purduerov/X11-Solenoid-Board/notes.txt

Fix airwires
Min trace width of 10 for signals, 30 for power
Leave pads straight out instead of skewed
Keep a trace width between traces
Add a GND polygon to the bottom side
Via stitch the GND planes
Mounting holes/standoffs, make sure they are aligned and sane. You might only fit 3, thats ok
SW, 12V, 24V, related should be width 30
Do not route anything through the region near an oscillator
Swap CAN_H, CAN_L with +12V, GND on the input T2I connector, move the CAN transceiver down instead
Bulk cap goes up top

Grant's Notes:
GND airwires due to isolate, min width, and ground stitching. Fixed
Still angled traced on decoupling caps below micro. Left some as is 
2 small GND polygons not filling in. 
+3.3V instead of +3V3. Fixed. Is it ok to run the shift register's power through the same trace as the micro?
redid +12V around the inductor. +12 now splits 1) to inductor and 2) to cap  and through to IC and SHDN trace
Should there be ground plane beneath the inductor?
