purduerov/X11-Solenoid-Board/Solenoid Boardv2.brd

## EAGLE design Solenoid Boardv2.brd (2019-03-25)

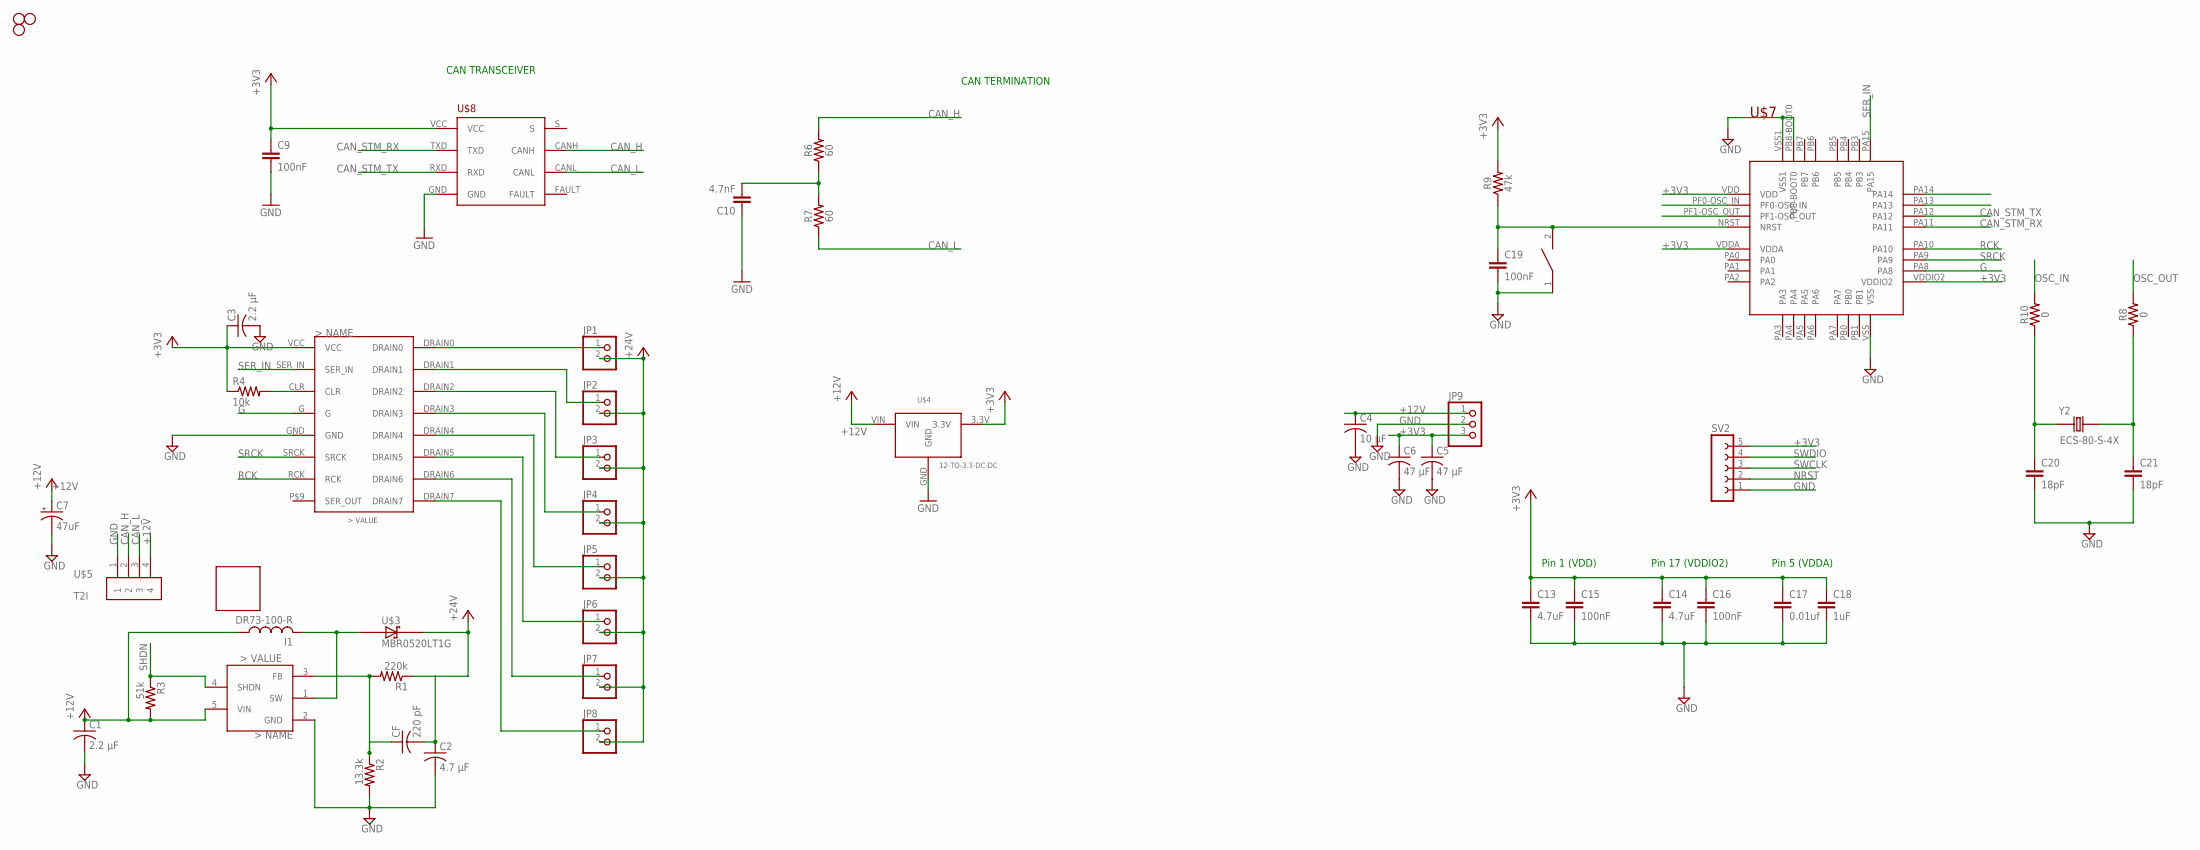
[picture p1: schematic Solenoid Boardv2.sch]

Parts:
C1, C3: 2.2 µF; C0805
C2: 4.7 µF; C0805
C4: 10 µF; C0805
C5, C6: 47 µF; C0805
C7: 47uF; PANASONIC_D
C9, C15, C16, C19: 100nF; 0603
C10: 4.7nF; 0603
C13, C14: 4.7uF; 0603
C17: 0.01uf; 0603
C18: 1uF; 0603
C20, C21: 18pF; 0603
CF: 220 pF; C0805
H1, H2, H3: STAND-OFF
I1: DR73-100-R
JP1, JP2, JP3, JP4, JP5, JP6, JP7, JP8: PINHD-1X2; 1X02
JP9: PINHD-1X3; 1X03
R1: 220k; R0603
R2: 13.3k; R0603
R3: 51k; R0603
R4: 10k; R0603
R6, R7: 60; 0603
R8, R10: 0; 0603
R9: 47k; 0603
RESET1: SWITCH; SW_2512
SV2: FE05-1
U$1: SHIFT_REGISTER
U$2: LM27313; SOT95P300X145-5
U$3: MBR0520LT1G; SOD3716X135
U$4: 12-TO-3.3-DC-DC; MURATA-DCDC
U$5: T2I
U$6: BOARDPNE; PNE
U$7: STM32F042K6T6
U$8: TCAN337D
Y2: ECS-80-S-4X; XTAL_ECS-80-S-4X

Connections:
+3V3: C3.1, C5.1, C6.1, C9.1, C13.1, C14.1, C15.1, C16.1, C17.1, C18.1, JP9.3, R4.1, R9.2, SV2.5, U$1.VCC, U$4.3.3V, U$7.VDD, U$7.VDDA, U$7.VDDIO2, U$8.VCC
+12V: C1.1, C4.1, C7.+, I1.1, JP9.1, R3.2, U$2.5 (VIN), U$4.VIN, U$5.4
+24V: C2.1, CF.2, JP1.2, JP2.2, JP3.2, JP4.2, JP5.2, JP6.2, JP7.2, JP8.2, R1.1, U$3.2 (C)
CAN_H: R6.2, U$5.2, U$8.CANH
CAN_L: R7.1, U$5.3, U$8.CANL
CAN_STM_RX: U$7.PA11, U$8.TXD
CAN_STM_TX: U$7.PA12, U$8.RXD
CLR: R4.2, U$1.CLR
DRAIN0: JP1.1, U$1.DRAIN0
DRAIN1: JP2.1, U$1.DRAIN1
DRAIN2: JP3.1, U$1.DRAIN2
DRAIN3: JP4.1, U$1.DRAIN3
DRAIN4: JP5.1, U$1.DRAIN4
DRAIN5: JP6.1, U$1.DRAIN5
DRAIN6: JP7.1, U$1.DRAIN6
DRAIN7: JP8.1, U$1.DRAIN7
FB: CF.1, R1.2, R2.1, U$2.3 (FB)
G: U$1.G, U$7.PA8
GND: C1.2, C2.2, C3.2, C4.2, C5.2, C6.2, C7.-, C9.2, C10.1, C13.2, C14.2, C15.2, C16.2, C17.2, C18.2, C19.2, C20.2, C21.2, JP9.2, R2.2, RESET1.1, SV2.1, U$1.GND, U$2.2 (GND), U$4.GND, U$5.1, U$7.PB8-BOOT0, U$7.VSS, U$7.VSS1, U$8.GND
unnamed: C21.1, R8.1, Y2.2
unnamed: C20.1, R10.1, Y2.1
unnamed: C10.2, R6.1, R7.2
NRST: C19.1, R9.1, RESET1.2, SV2.2, U$7.NRST
OSC_IN: R10.2, U$7.PF0-OSC_IN
OSC_OUT: R8.2, U$7.PF1-OSC_OUT
RCK: U$1.RCK, U$7.PA10
SER_IN: U$1.SER_IN, U$7.PA15
SHDN: R3.1, U$2.4 (SHDN)
SRCK: U$1.SRCK, U$7.PA9
SW: I1.2, U$2.1 (SW), U$3.1 (A)
SWCLK: SV2.3, U$7.PA14
SWDIO: SV2.4, U$7.PA13

Notes on the sheet:
Pin 1 (VDD)
Pin 17 (VDDIO2)
Pin 5 (VDDA)
CAN TRANSCEIVER
CAN TERMINATION

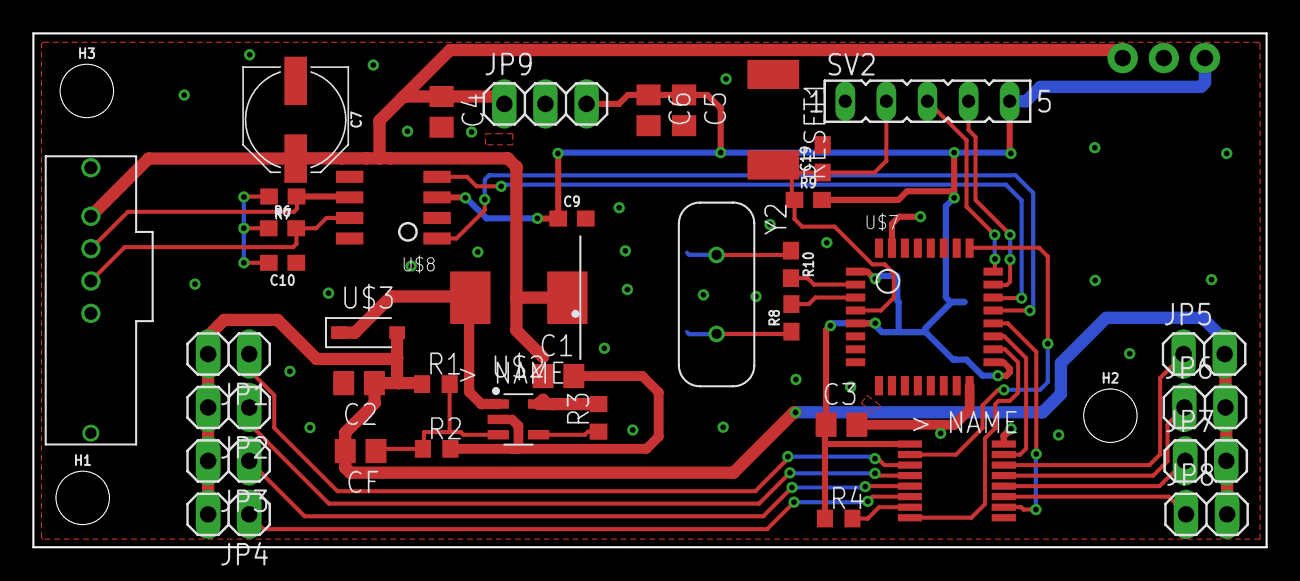
[picture p2: board Solenoid Boardv2.brd from above]

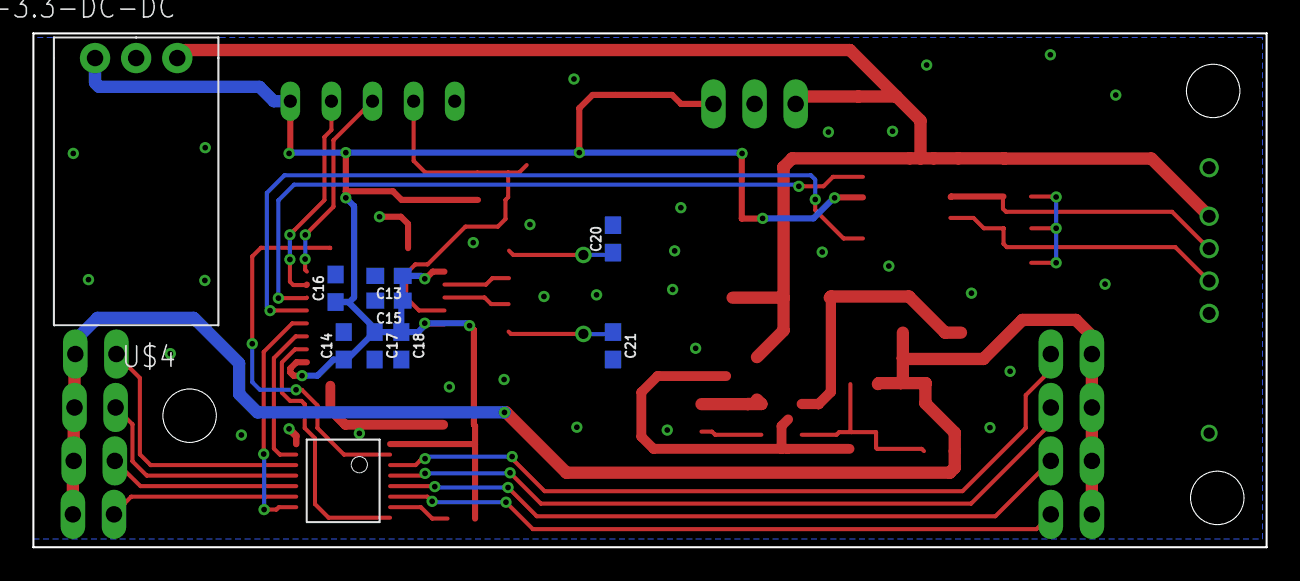
[picture p3: board Solenoid Boardv2.brd from below]

Board: 2 copper layers, 76.2 x 31.8 mm, 52 parts (9 on the bottom side), 32 nets.
