purduerov/X11-Solenoid-Board/(commit log)

2018-10-20 Created board schematic (blank)
    [Solenoid Board.sch]
2018-11-08 Added frame and stm block
    [Solenoid Board.brd, Solenoid Board.sch]
2018-11-10 Created the board layout
    [Solenoid Board.brd, Solenoid Board.sch]
2018-11-15 Routed most of the board
    [Solenoid Board.brd]
2018-11-29 Well it's trash but board layout v1 is done
    [Solenoid Board.brd]
2018-11-29 Started work on the solenoid board v2
    [Solenoid Boardv2.brd, Solenoid Boardv2.sch]
2018-12-02 Made progress on V2, added polygons and headers for step down converter
    [Solenoid Boardv2.brd, Solenoid Boardv2.sch]
2019-01-03 Added the can module
    [Solenoid Boardv2.brd, Solenoid Boardv2.sch]
2019-01-04 changes from design review
    [Solenoid Boardv2.brd, Solenoid Boardv2.sch]
2019-01-05 WIP changing route widths
    [Solenoid Boardv2.brd, Solenoid Boardv2.sch]
2019-01-05 Added required revisions from design review
    [Solenoid Boardv2.brd]
2019-01-05 Moved nsrt around the osc signals
    [Solenoid Boardv2.brd]
2019-01-05 Fixed the via stitching
    [Solenoid Boardv2.brd]
2019-01-06 Fixed airwires and aligned the solenoid header pins
    [Solenoid Boardv2.brd]
2019-01-06 Grant's revisions. Detailed in notes.txt
    [Solenoid Boardv2.brd, Solenoid Boardv2.sch]
2019-01-06 Added question add ground plane and inductor
2019-01-07 Fixed some clearance issues
    [Solenoid Boardv2.brd]
2019-01-07 fixed a weird trace, moved a standoff hole a little so that it didnt overlap with a trace
    [Solenoid Boardv2.brd]
2019-01-07 GND wasnt fully routed, fixed
    [Solenoid Boardv2.brd]
2019-03-25 revised boost converter resistors and added data sheet for boost converter
    [Solenoid Boardv2.brd, Solenoid Boardv2.sch]
